piyushops01/kancha-bot-delhi-robotics-league/docs/CAD Model & Circuit Link.docx

Tinkercad Link

https://www.tinkercad.com/things/iN1c5valeRQ-final/edit?sharecode=2Y9eHm3tryb3fXrdfdQPKgWki3Zt0JGxeXu6Aq2MZfY

Canva Circuit Link

https://www.canva.com/design/DAFkySpYa48/2PC6o44fmmzJXb--uU_QPQ/edit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
