piyushops01/kancha-bot-delhi-robotics-league/docs/Devaition from Stage 1 TECH - DECODERS.pdf

# Deviation From Stage 1

Team ID: 36

Team Name: TECH-DECODERS

Mentor Name: Mr. Shubham Jain

Team Members

Main | | Supporting
1. | Piyush | 6. 7. Lavish
2. | Gurmeet Singh | 8. Vainessa Sharma

### 3. Ashmit Raj Nishad

### 4. Chirag

### 5. Gaurav Joshi

# Stage 1 Cad deSign

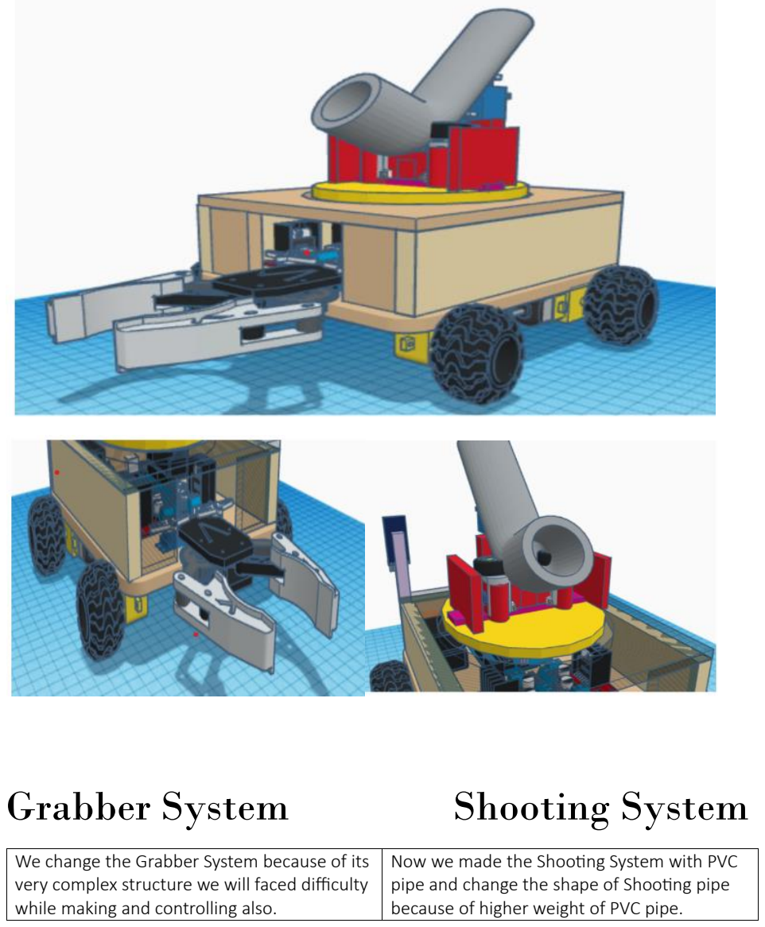
[picture p6: page 2]

Grabber System | Shooting System
We change the Grabber System because of its very complex structure we will faced difficulty while making and controlling also. | Now we made the Shooting System with PVC pipe and change the shape of Shooting pipe because of higher weight of PVC pipe.

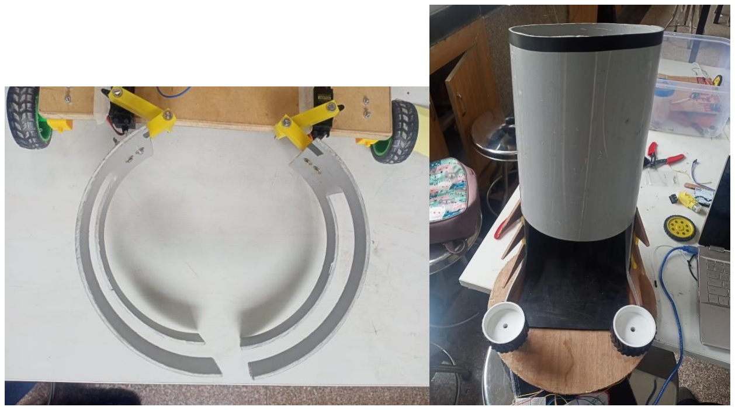
[picture p7: figure]

## Wireless Communication :

Firstly, we decided to choose NRF Transreciever Module (Nrf24L01) for wireless communication due to facing many issues while transmitting and receiving data. Now, we decided to use HC-05 Bluetooth Module for transmitting and receiving data and make our robot.

## Wheels & Motors :

Firstly, we decided to choose Mecanum Wheel for multi-directional movement and rotation. But the couplers of mecnum wheels are not available. So, we decided at the end to change the motors to RS-555 DC Motor.

NOTE: For video submission we used Bo Motors and Simple Wheels. But on the final, we use RS-555 DC Motor.

## Circular Disc :

In Stage 1, we planned to rotate the Shooting Mechanism of Circular Disc. But we drop our plan because we facing some problem while mounting the shooting mechanism.

# Final View OF ROBOt

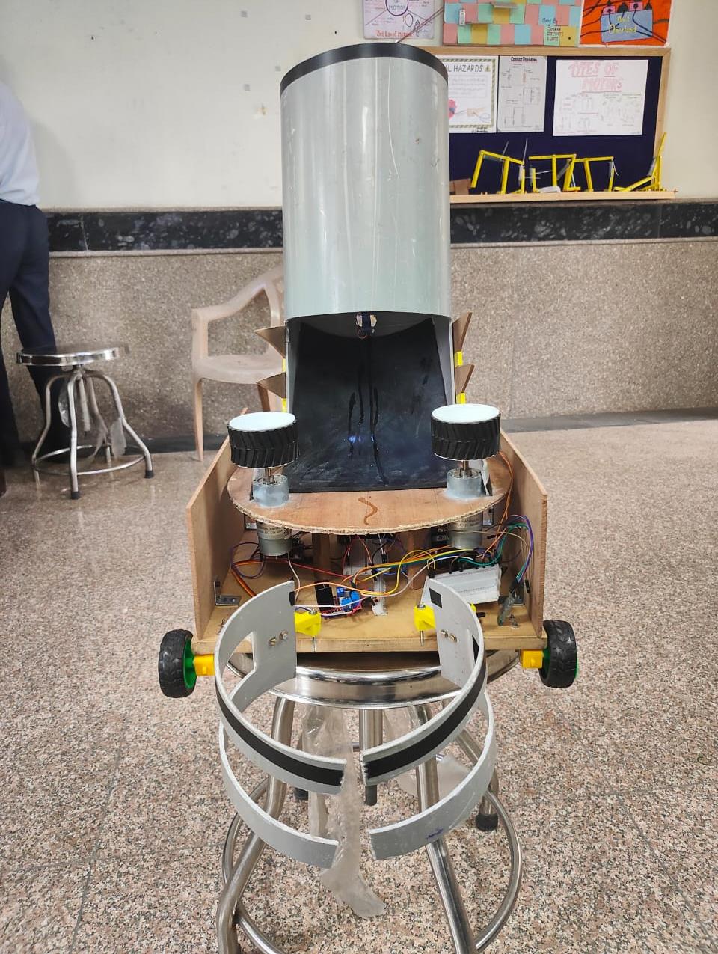
[picture p8: figure]
