piyushops01/kancha-bot-delhi-robotics-league/images/TECH DECODER CIRCUIT DIAGRAM_Kancha-bot.jpg

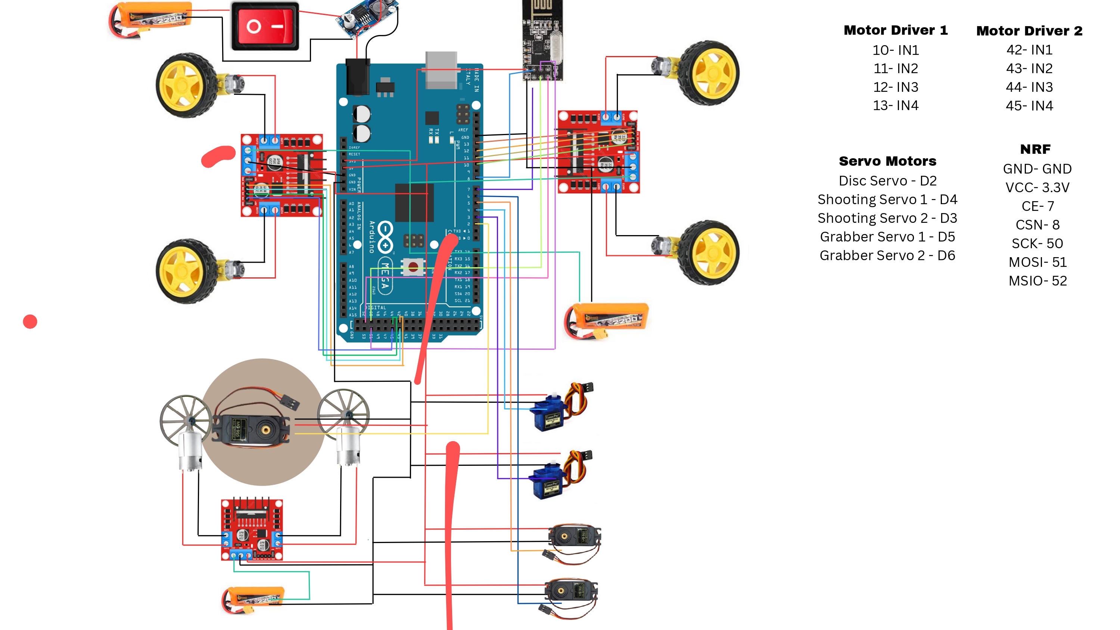
images/TECH DECODER CIRCUIT DIAGRAM_Kancha-bot.jpg
