piyushops01/kancha-bot-delhi-robotics-league/images/TECH DECODER CIRCUIT DIAGRAM_Wireless-Remote.jpg

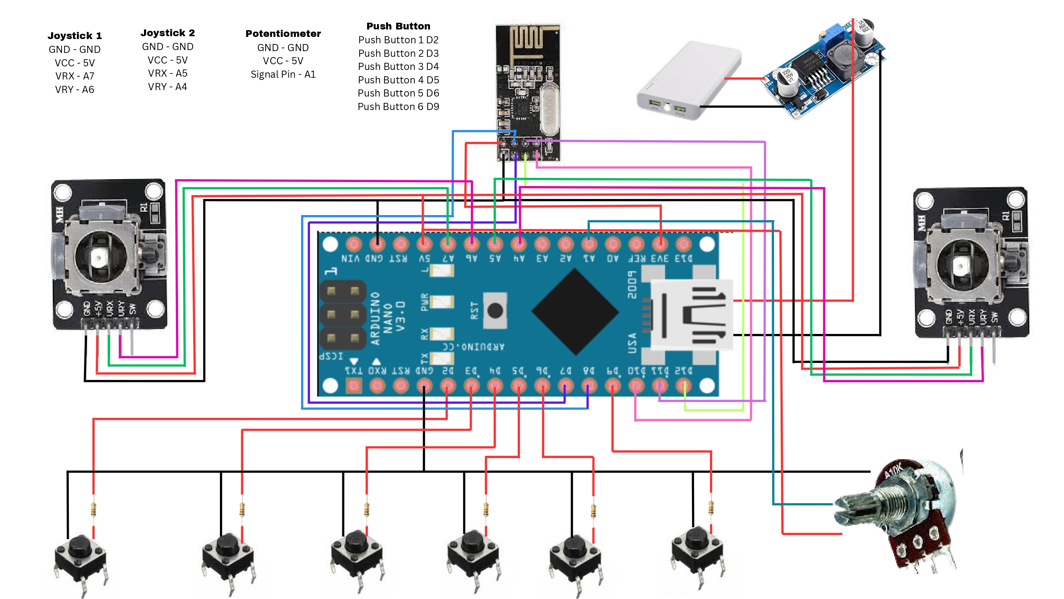
images/TECH DECODER CIRCUIT DIAGRAM_Wireless-Remote.jpg
