piyushops01/kancha-bot-delhi-robotics-league/images/Signal Flowchart Of Components TECH_DECODER.jpg

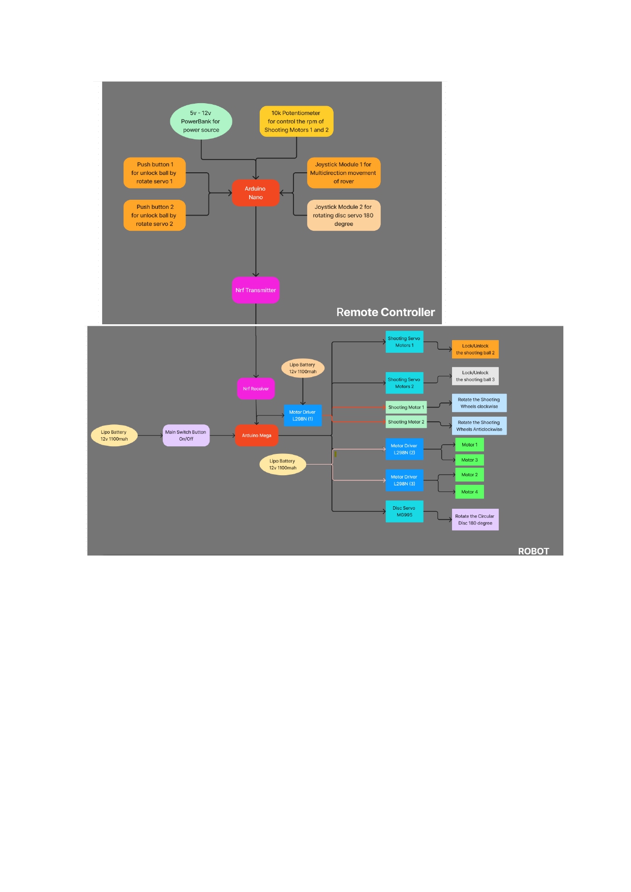
images/Signal Flowchart Of Components TECH_DECODER.jpg
