piyushops01/kancha-bot-delhi-robotics-league/cad/KANCHA BOT.stl

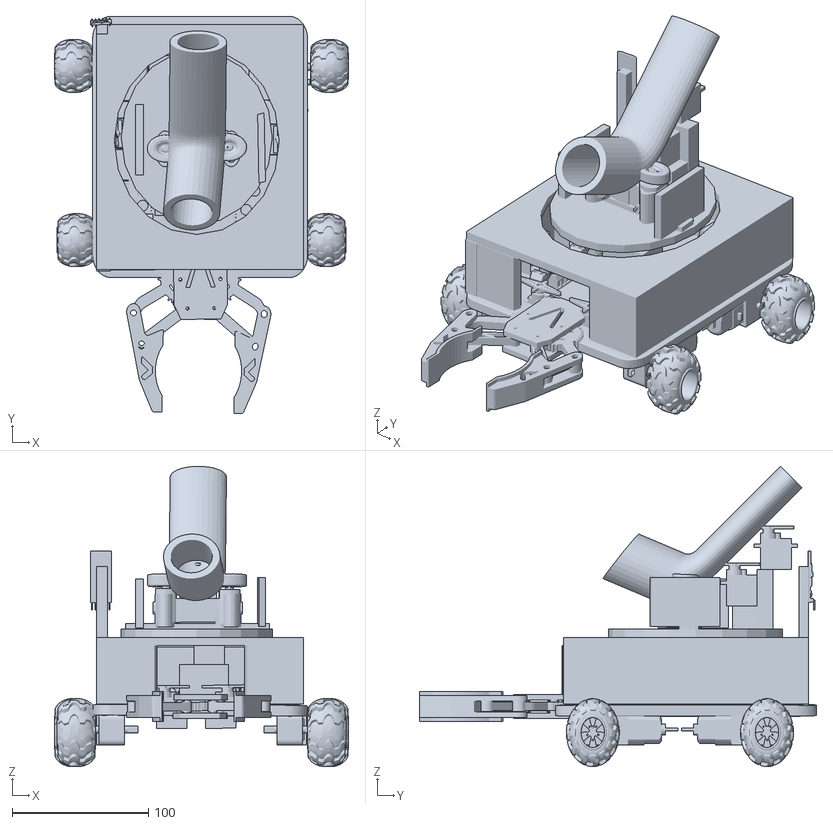
[picture p13: CAD file, 2026-10-16]
cad/KANCHA BOT.stl
216.0 x 292.0 x 220.6
