piyushops01/kancha-bot-delhi-robotics-league/(list of files, cad)

Other CAD files:
cad/tinker.obj
