piyushops01/kancha-bot-delhi-robotics-league/docs/Refernce_ Guides.docx

https://youtu.be/lh (https://youtu.be/lhGXAJj8rJw)

(https://youtu.be/lhGXAJj8rJw)GXAJj8rJw (https://youtu.be/lhGXAJj8rJw)NRF Wireless Joystick Remote

https://www.hackster.io/Arnov_Sharma_makes/nrf24-hookup-guide-97b240

NRF 24 Hookup Guide

https://youtu.be/uilIwkJGtfI

https://www.tinkercad.com/things/lXNuEd5PArK-copy-of-kancha-bot/edit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

Tinker cad link

Arduino NRF24L01 Joystick Controller Remote Transmitter (https://youtu.be/8GSP8-W687g)

Nrf controller remote link

https://youtu.be/SWozQLhSURY

Grabber_Motor_Servo

https://www.tinkercad.com/things/1qQZHxuPjSp-copy-of-the-clawwwwwwwww/edit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

Grabber tinkercad link

https://youtu.be/sNpCTsVifo4

Bluetooth App

Creating Bluetooth App with Thunkable (https://youtu.be/KJUZncOJjyI)

https://youtu.be/hMDNG7vYCAY

DIY Shooting Mechanism
