piyushops01/kancha-bot-delhi-robotics-league/codes/CODES/Transmitter.12.ino

#include <SPI.h>
#include <nRF24L01.h>
#include <RF24.h>

#define buttton 4 // for servo
#define button  41
#define button  42

RF24 radio(7, 8); // CE, CSN

const byte address[6] = "00001";

void setup() {
  radio.begin();
  radio.openWritingPipe(address);
  radio.setPALevel(RF24_PA_MIN);
  radio.stopListening();
}

void loop() {
  const char text[] = "Hello World";
  radio.write(&text, sizeof(text));
  delay(1000);
}
